MoWaleid/Convlution_Accelerator/Important documents/Architecture_Mapping.html

# Architecture Decision Mapping

This document maps the complete list of 17 recommended architecture decisions from the CNN_Accelerator_Spec_Decisions.pdf specification to the current VHDL implementation in the project.

## Decision Matrix

# | Decision Area | Recommended Choice (Spec) | Implemented Choice (Project) | Status | Rationale / Location

1 | Input pixel format | 8-bit unsigned integer (Q8.0) | 8-bit unsigned integer | Matched | Implemented in config_pkg.vhd (CFG_PIXEL_WIDTH = 8). Matches golden model.
2 | Kernel format | Raw signed 8-bit integer | Raw signed 8-bit integer | Matched | Implemented in config_pkg.vhd (CFG_WEIGHT_WIDTH = 8). Matches golden model.
3 | Accumulator width | Worst-case formula (21 bits for N=3) | 24 bits | Matched | Implemented in config_pkg.vhd (CFG_ACCUM_WIDTH = 24). Rounded up for cleaner DSP/fabric boundaries.
4 | Rescale shift | Programmable per-channel | Programmable per-channel | Matched | Implemented via AXI control in coeff_bias_shift_regfile.vhd (Word 33 per channel).
5 | Rounding | Round-half-up | TBD (Golden Model Matched) | Pending RTL | Currently verified in golden model (golden_conv.py), but the RTL datapath array (MAC units) is not yet built.
6 | Overflow handling | Saturate | TBD (Golden Model Matched) | Pending RTL | Currently verified in golden model (golden_conv.py), but the RTL datapath array (MAC units) is not yet built.
7 | Boundary convention | "Valid" convolution (no padding) | "Valid" convolution | Matched | Implemented in window_generator.vhd. valid_out only asserts after N-1 rows/cols. Golden model manually pre-pads to verify.
8 | Kernel-size (N) | Compile-time VHDL generic, default N=3 | Compile-time generic, N=3 | Matched | Implemented in config_pkg.vhd (CFG_N = 3).
9 | Multi-kernel parallelism | K shared-window channels, target K=4 | K=16 channels | Exceeded | Implemented in config_pkg.vhd (CFG_K = 16). Provides 4x higher parallelism than the baseline target.
10 | Compute topology | Direct parallel MAC array | TBD | Pending RTL | RTL datapath array not yet built.
11 | Multiplier implementation | LUT-fabric (use_dsp=no) | TBD | Pending RTL | RTL datapath array not yet built.
12 | Line-buffer memory | SRL-based fabric shift registers (zero BRAM) | SRL-based arrays | Matched | Implemented in window_generator.vhd using 1D arrays of std_logic_vector to infer SRL32s.
13 | Pipelining | 3-5 structural stages + Vivado retiming | TBD | Pending RTL | RTL datapath array not yet built.
14 | ReLU | Per-channel runtime-toggleable | Per-channel runtime-toggleable | Matched | Implemented via AXI control in coeff_bias_shift_regfile.vhd (Bit 8 of Word 33 per channel).
15 | Control interface | AXI4-Lite register map | AXI4-Lite | Matched | Implemented in axi_lite_ctrl.vhd mapping to the register file.
16 | Data interface | AXI4-Stream + AXI DMA (PS DDR ↔ PL) | TBD | Pending RTL | Top-level block and AXI-Stream interfaces have not been assembled yet.
17 | PS software stack | PetaLinux + native on-target Python | TBD | Pending Software | The hardware-software integration phase has not been started yet.

## Summary

The current RTL implementation closely follows the recommendations outlined in the specification document for all of the modules built so far. Notably, the hardware achieves zero BRAM usage for line buffers by correctly utilizing SRL primitives. It also incorporates all mandatory runtime programmability requirements (per-channel rescale shifts and ReLU enables) over a standard AXI4-Lite interface. Furthermore, the design pushes performance beyond the baseline target by implementing 16 parallel output channels (K=16) instead of the requested 4.

Note: The core MAC array (Compute Topology, Multipliers, Pipelining, Rounding, Overflow Handling), Top-Level Data Interfaces (AXI-Stream), and PS Software Stack are currently marked as pending as they have not yet been implemented in the source files. The Golden Model scripts already implement the correct Rounding and Saturation logic pending RTL integration.
