MoWaleid/Convlution_Accelerator/report/figures/fig7_utilization.png

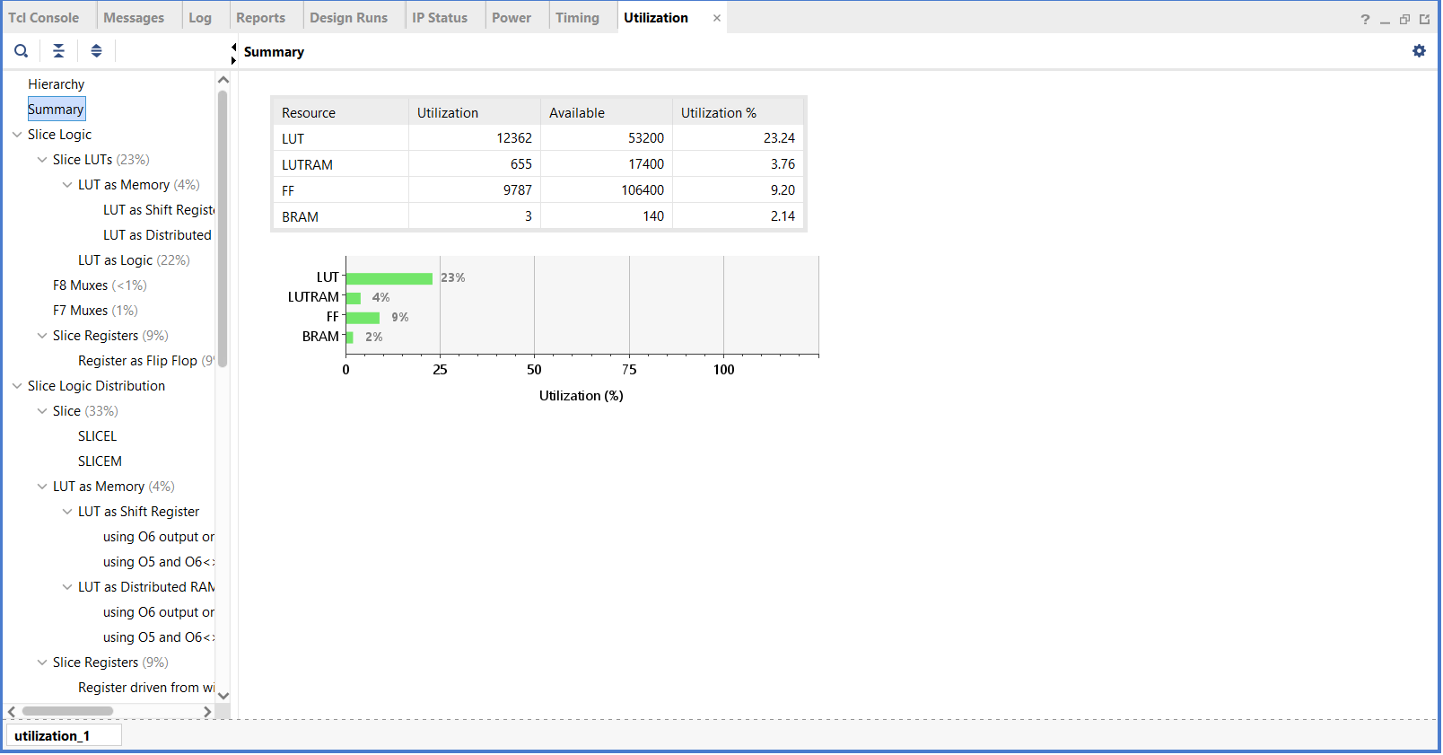
report/figures/fig7_utilization.png
