MoWaleid/Convlution_Accelerator/report/figures/fig8_timing_summary.png

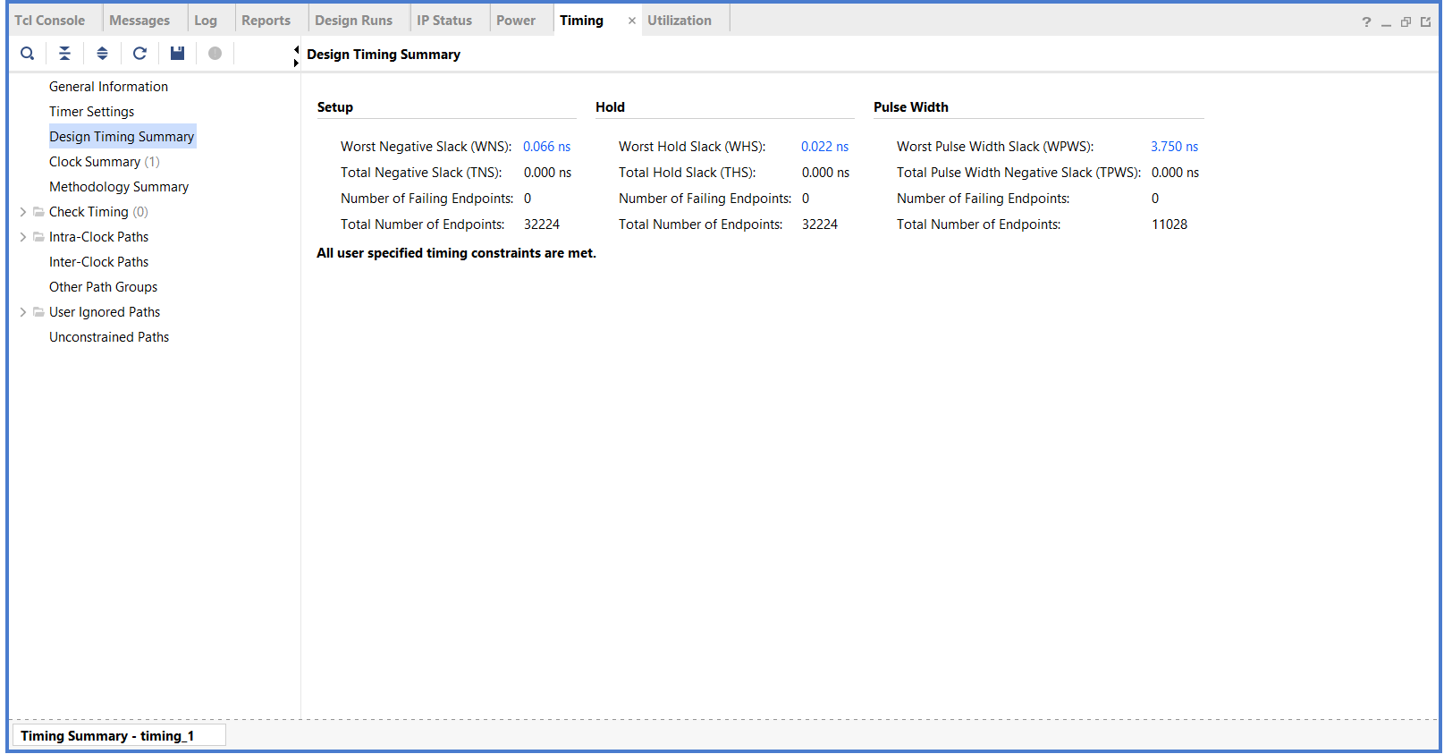
report/figures/fig8_timing_summary.png
