MoWaleid/Convlution_Accelerator/deploy/petalinux/recipes-apps/conv-lab-validation/files/INSTALLED_SHA256SUMS.txt

ea9cca2efb4a6f9e74c8f9849b9e1d61bbfc4c97b9649718dbb82cb657fc61f1  /opt/conv-lab/app/conv_lab/__init__.py
0ccd1de3e55b3437ee6acf62e0fa21a69f0a7768752000d04625c2480c98fd29  /opt/conv-lab/app/conv_lab/_decoder_worker.py
7d66fa962028779ab764f58c7f8f79614e87b4f32e368aeddb5187a3a1e163a5  /opt/conv-lab/app/conv_lab/admission.py
b2878de9ea6ba7eecb173c680f9a57cc86487c63c51e9f7723fe9634d21ecaa7  /opt/conv-lab/app/conv_lab/bundles.py
992064e55daa3645f3b8337a1cb6f19396265100392b3cc030cf270d5da5d981  /opt/conv-lab/app/conv_lab/convert_legacy.py
26fe9c3177d2a8651487007d6498370f98942abf5b35c8494a605ac6e15d09a9  /opt/conv-lab/app/conv_lab/dma.py
7afdc2dead21b8273672f3de1dd12226209d65b82ccc8693de7ca26805de04c5  /opt/conv-lab/app/conv_lab/errors.py
73b7eba7304ad4c4b50bce89c4152326523df2a3f7790c08b00de94c888f8b11  /opt/conv-lab/app/conv_lab/legacy.py
b40445999fc7e04be0155ae02ecb6b5809e3e08e5c1e81720246cf3e39aa152f  /opt/conv-lab/app/conv_lab/offline.py
c749fd176e401258018ea5ea97697aa9c52eed748435e0daa05fc4213cc9891e  /opt/conv-lab/app/conv_lab/preprocessing.py
5172c6d424bf7aa90a54846889cb2cec460f3103ce2590d96baac65529c433b6  /opt/conv-lab/app/conv_lab/reference.py
957431e5d61774b103c58749986a42b1845c5fe769215b402d80a4c9a57ceacb  /opt/conv-lab/app/conv_lab/release_io.py
b4636e79ecac3af7c026b600c922b88e42f8ad961f2bf09d54d50d0886fdfb4a  /opt/conv-lab/app/conv_lab/schemas.py
11f0179c3eb9cf5c3550df679c88ec458b3b3c65424d7ce08f84249e9b40b35e  /opt/conv-lab/app/conv_lab/storage.py
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
31ff39dc84828e4fa7e72bd1b80c5df45dcf4306496224f2f61cc4b8c449ac43  /opt/conv-lab/validation/evidence/trained_cifar_vector_audit.json
86ce223687c98172ad5373c92d0769511cdd74217537005fe965fecae31337bb  /usr/bin/conv-lab-offline
edb60cf0b1d1d7fb573ff32e75457183acfbf16c7d70dd74741c73bda96941d7  /usr/bin/conv-lab-tests
2df9cb271536a6e89c38f94c4c132c7f7f1e92b46783822e8adbfab15a9573c2  /usr/sbin/conv-lab-prepare-output
