MoWaleid/Convlution_Accelerator/report/research_builds/B32_CFGLUT125/rebuild_20260915/results.txt

release_id=B32_CFGLUT125
shape_id=N3K16W32H32-CVH1
MHz=125
WNS=0.090
WHS=0.053
BOARD_VALIDATION=NOT_RUN
