MoWaleid/Convlution_Accelerator/report/research_builds/CFGLUT125_MATRIX/wrapper_official_user_20260914T210835Z/A32_CFGLUT125__optimized/run_result.txt

PROFILE_WRAPPER_IDENTITY_OK: A32_CFGLUT125 K=8 N=3 W=32 H=32 build_id=45463132354b30384e33573332523031
PROFILE_WRAPPER_PASS: A32_CFGLUT125 optimized
OPTION_A_EXTERNAL_GAPLESS_CLAIM=yes
