MoWaleid/Convlution_Accelerator/report/research_builds/CFGLUT125_MATRIX/wrapper_official_user_20260914T210835Z/C32_CFGLUT125__optimized_relaxed/run_result.txt

PROFILE_WRAPPER_IDENTITY_OK: C32_CFGLUT125 K=8 N=5 W=32 H=32 build_id=45463132354b30384e35573332523031
PROFILE_WRAPPER_PASS: C32_CFGLUT125 optimized_relaxed
OPTION_A_EXTERNAL_GAPLESS_CLAIM=no
