MoWaleid/Convlution_Accelerator/report/research_builds/CFGLUT125_MATRIX/wrapper_official_user_20260914T210835Z/D640_CFGLUT125__optimized_relaxed/run_result.txt

PROFILE_WRAPPER_IDENTITY_OK: D640_CFGLUT125 K=4 N=3 W=640 H=480 build_id=45463132354e334b30345647412d5231
PROFILE_WRAPPER_PASS: D640_CFGLUT125 optimized_relaxed
OPTION_A_EXTERNAL_GAPLESS_CLAIM=no
