MoWaleid/Convlution_Accelerator/report/research_builds/D32_CFGLUT125/results.txt

release_id=D32_CFGLUT125
shape_id=N3K4W32H32-CVH1
MHz=125
WNS=0.093
WHS=0.014
BOARD_VALIDATION=NOT_RUN
