MoWaleid/Convlution_Accelerator/report/research_builds/A32_CFGLUT125/results.txt

release_id=A32_CFGLUT125
shape_id=N3K8W32H32-CVH1
MHz=125
WNS=0.197
WHS=0.037
BOARD_VALIDATION=NOT_RUN
