MoWaleid/Convlution_Accelerator/report/research_builds/D640_CFGLUT125/results.txt

release_id=D640_CFGLUT125
shape_id=N3K4W640H480-CVH1
MHz=125
WNS=0.001
WHS=0.022
BOARD_VALIDATION=NOT_RUN
