MoWaleid/Convlution_Accelerator/report/research_builds/C32_CFGLUT125/results.txt

release_id=C32_CFGLUT125
shape_id=N5K8W32H32-CVH1
MHz=125
WNS=0.003
WHS=0.037
BOARD_VALIDATION=NOT_RUN
