MoWaleid/Convlution_Accelerator/report/research_builds/B32_CFGLUT100/results.txt

release_id=B32_CFGLUT100
shape_id=N3K16W32H32-CVH1
MHz=100
WNS=0.764
WHS=0.011
BOARD_VALIDATION=NOT_RUN
