MoWaleid/Convlution_Accelerator/Convlution_Accelerator.srcs/sources_1/new/conv_axis_wrapper_bd.v

// Vivado IP Integrator module-reference adapter for the VHDL-2008 wrapper.
// The adapter adds standard AXI interface metadata and normalizes physical
// addresses to local 64 KiB offsets for conv_axis_wrapper.vhd.
`timescale 1 ns / 1 ps

module conv_axis_wrapper_bd (
    (* X_INTERFACE_INFO = "xilinx.com:signal:clock:1.0 clk CLK" *)
    // FREQ_HZ is intentionally omitted.  The connected PS FCLK is the single
    // clock authority, allowing the same RTL to be built as a checked 100 MHz
    // or 125 MHz release without stale module-reference metadata.
    (* X_INTERFACE_PARAMETER = "XIL_INTERFACENAME clk, ASSOCIATED_BUSIF S_AXI:S_AXIS:M_AXIS, ASSOCIATED_RESET resetn" *)
    input wire clk,
    (* X_INTERFACE_INFO = "xilinx.com:signal:reset:1.0 resetn RST" *)
    (* X_INTERFACE_PARAMETER = "XIL_INTERFACENAME resetn, POLARITY ACTIVE_LOW" *)
    input wire resetn,

    // The BD address map constrains this slave to an aligned 64 KiB aperture covering
    // the frozen local offsets through 0x400C. Keep the native 32-bit AXI
    // address ports so Vivado's AXI interface metadata matches the core.
    (* X_INTERFACE_INFO = "xilinx.com:interface:aximm:1.0 S_AXI AWADDR" *) input wire [31:0] S_AXI_AWADDR,
    (* X_INTERFACE_INFO = "xilinx.com:interface:aximm:1.0 S_AXI AWPROT" *) input wire [2:0] S_AXI_AWPROT,
    (* X_INTERFACE_INFO = "xilinx.com:interface:aximm:1.0 S_AXI AWVALID" *) input wire S_AXI_AWVALID,
    (* X_INTERFACE_INFO = "xilinx.com:interface:aximm:1.0 S_AXI AWREADY" *) output wire S_AXI_AWREADY,
    (* X_INTERFACE_INFO = "xilinx.com:interface:aximm:1.0 S_AXI WDATA" *) input wire [31:0] S_AXI_WDATA,
    (* X_INTERFACE_INFO = "xilinx.com:interface:aximm:1.0 S_AXI WSTRB" *) input wire [3:0] S_AXI_WSTRB,
    (* X_INTERFACE_INFO = "xilinx.com:interface:aximm:1.0 S_AXI WVALID" *) input wire S_AXI_WVALID,
    (* X_INTERFACE_INFO = "xilinx.com:interface:aximm:1.0 S_AXI WREADY" *) output wire S_AXI_WREADY,
    (* X_INTERFACE_INFO = "xilinx.com:interface:aximm:1.0 S_AXI BRESP" *) output wire [1:0] S_AXI_BRESP,
    (* X_INTERFACE_INFO = "xilinx.com:interface:aximm:1.0 S_AXI BVALID" *) output wire S_AXI_BVALID,
    (* X_INTERFACE_INFO = "xilinx.com:interface:aximm:1.0 S_AXI BREADY" *) input wire S_AXI_BREADY,
    (* X_INTERFACE_INFO = "xilinx.com:interface:aximm:1.0 S_AXI ARADDR" *) input wire [31:0] S_AXI_ARADDR,
    (* X_INTERFACE_INFO = "xilinx.com:interface:aximm:1.0 S_AXI ARPROT" *) input wire [2:0] S_AXI_ARPROT,
    (* X_INTERFACE_INFO = "xilinx.com:interface:aximm:1.0 S_AXI ARVALID" *) input wire S_AXI_ARVALID,
    (* X_INTERFACE_INFO = "xilinx.com:interface:aximm:1.0 S_AXI ARREADY" *) output wire S_AXI_ARREADY,
    (* X_INTERFACE_INFO = "xilinx.com:interface:aximm:1.0 S_AXI RDATA" *) output wire [31:0] S_AXI_RDATA,
    (* X_INTERFACE_INFO = "xilinx.com:interface:aximm:1.0 S_AXI RRESP" *) output wire [1:0] S_AXI_RRESP,
    (* X_INTERFACE_INFO = "xilinx.com:interface:aximm:1.0 S_AXI RVALID" *) output wire S_AXI_RVALID,
    (* X_INTERFACE_INFO = "xilinx.com:interface:aximm:1.0 S_AXI RREADY" *) input wire S_AXI_RREADY,

    (* X_INTERFACE_INFO = "xilinx.com:interface:axis:1.0 S_AXIS TDATA" *) input wire [63:0] s_axis_tdata,
    (* X_INTERFACE_INFO = "xilinx.com:interface:axis:1.0 S_AXIS TKEEP" *) input wire [7:0] s_axis_tkeep,
    (* X_INTERFACE_INFO = "xilinx.com:interface:axis:1.0 S_AXIS TVALID" *) input wire s_axis_tvalid,
    (* X_INTERFACE_INFO = "xilinx.com:interface:axis:1.0 S_AXIS TREADY" *) output wire s_axis_tready,
    (* X_INTERFACE_INFO = "xilinx.com:interface:axis:1.0 S_AXIS TLAST" *) input wire s_axis_tlast,

    (* X_INTERFACE_INFO = "xilinx.com:interface:axis:1.0 M_AXIS TDATA" *) output wire [63:0] m_axis_tdata,
    (* X_INTERFACE_INFO = "xilinx.com:interface:axis:1.0 M_AXIS TKEEP" *) output wire [7:0] m_axis_tkeep,
    (* X_INTERFACE_INFO = "xilinx.com:interface:axis:1.0 M_AXIS TVALID" *) output wire m_axis_tvalid,
    (* X_INTERFACE_INFO = "xilinx.com:interface:axis:1.0 M_AXIS TREADY" *) input wire m_axis_tready,
    (* X_INTERFACE_INFO = "xilinx.com:interface:axis:1.0 M_AXIS TLAST" *) output wire m_axis_tlast
);

    conv_axis_wrapper accelerator_i (
        .clk(clk),
        .resetn(resetn),
        .S_AXI_AWADDR({16'h0000, S_AXI_AWADDR[15:0]}),
        .S_AXI_AWPROT(S_AXI_AWPROT),
        .S_AXI_AWVALID(S_AXI_AWVALID),
        .S_AXI_AWREADY(S_AXI_AWREADY),
        .S_AXI_WDATA(S_AXI_WDATA),
        .S_AXI_WSTRB(S_AXI_WSTRB),
        .S_AXI_WVALID(S_AXI_WVALID),
        .S_AXI_WREADY(S_AXI_WREADY),
        .S_AXI_BRESP(S_AXI_BRESP),
        .S_AXI_BVALID(S_AXI_BVALID),
        .S_AXI_BREADY(S_AXI_BREADY),
        .S_AXI_ARADDR({16'h0000, S_AXI_ARADDR[15:0]}),
        .S_AXI_ARPROT(S_AXI_ARPROT),
        .S_AXI_ARVALID(S_AXI_ARVALID),
        .S_AXI_ARREADY(S_AXI_ARREADY),
        .S_AXI_RDATA(S_AXI_RDATA),
        .S_AXI_RRESP(S_AXI_RRESP),
        .S_AXI_RVALID(S_AXI_RVALID),
        .S_AXI_RREADY(S_AXI_RREADY),
        .s_axis_tdata(s_axis_tdata),
        .s_axis_tkeep(s_axis_tkeep),
        .s_axis_tvalid(s_axis_tvalid),
        .s_axis_tready(s_axis_tready),
        .s_axis_tlast(s_axis_tlast),
        .m_axis_tdata(m_axis_tdata),
        .m_axis_tkeep(m_axis_tkeep),
        .m_axis_tvalid(m_axis_tvalid),
        .m_axis_tready(m_axis_tready),
        .m_axis_tlast(m_axis_tlast)
    );

endmodule
