MoWaleid/Convlution_Accelerator/Convlution_Accelerator.srcs/sim_1/new/tb_conv_channel_shifts.vhd

-- ============================================================================
-- tb_conv_channel_shifts.vhd -- research-line numerical gauntlet
-- ============================================================================
-- Proves the CFGLUT5/Dadda channel against an independent 64-bit reference
-- across every encoded shift, signed-24 bias endpoints, exact half-rounding
-- boundaries, positive/negative nonzero products, saturation, and ReLU.
-- One item is kept in flight at a time so runtime parameters remain constant
-- for the complete arithmetic pipeline, matching the frame-level ABI.
-- ============================================================================

library IEEE;
use IEEE.STD_LOGIC_1164.ALL;
use IEEE.NUMERIC_STD.ALL;

library STD;
use STD.ENV.ALL;

library work;
use work.config_pkg.all;
use work.conv_pkg.all;

entity tb_conv_channel_shifts is
end entity tb_conv_channel_shifts;

architecture sim of tb_conv_channel_shifts is
    constant C_N          : positive := 3;
    constant C_K          : positive := 1;
    constant C_TAPS       : positive := C_N * C_N;
    constant C_WEIGHT_SETS : positive := 5;
    constant C_BIAS_CASES : positive := 8;
    constant CLK_PERIOD   : time := 8 ns;

    signal clk    : std_logic := '0';
    signal resetn : std_logic := '0';

    signal window_in : pixel_array_t(0 to C_TAPS - 1) :=
        (others => (others => '0'));
    signal valid_in : std_logic := '0';

    signal biases : bias_array_t(0 to C_K - 1) :=
        (others => (others => '0'));
    signal shifts : shift_array_t(0 to C_K - 1) :=
        (others => (others => '0'));
    signal relus : std_logic_vector(0 to C_K - 1) := (others => '0');

    signal coeff_write_pulse : std_logic := '0';
    signal coeff_write_addr  : std_logic_vector(31 downto 0) :=
        (others => '0');
    signal coeff_write_data  : std_logic_vector(31 downto 0) :=
        (others => '0');
    signal cfg_ready   : std_logic;
    signal results_out : output_array_t(0 to C_K - 1);
    signal valid_out   : std_logic;

    function weight_for(
        set_index : natural;
        tap       : natural
    ) return integer is
    begin
        case set_index is
            when 0 =>
                return 0;
            when 1 =>
                return 127;
            when 2 =>
                return -128;
            when 3 =>
                case tap is
                    when 0 => return -128;
                    when 1 => return -127;
                    when 2 => return -1;
                    when 3 => return 0;
                    when 4 => return 1;
                    when 5 => return 2;
                    when 6 => return 63;
                    when 7 => return 126;
                    when others => return 127;
                end case;
            when others =>
                case tap is
                    when 0 => return 127;
                    when 1 => return -128;
                    when 2 => return 85;
                    when 3 => return -86;
                    when 4 => return 64;
                    when 5 => return -65;
                    when 6 => return 3;
                    when 7 => return -2;
                    when others => return -1;
                end case;
        end case;
    end function weight_for;

    function packed_word(
        set_index  : natural;
        word_index : natural
    ) return std_logic_vector is
        variable value : std_logic_vector(31 downto 0) := (others => '0');
        variable tap   : natural;
    begin
        for lane in 0 to 3 loop
            tap := word_index * 4 + lane;
            if tap < C_TAPS then
                value(8 * lane + 7 downto 8 * lane) :=
                    std_logic_vector(to_signed(weight_for(set_index, tap), 8));
            end if;
        end loop;
        return value;
    end function packed_word;
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
