MoWaleid/Convlution_Accelerator/(commit log)

2026-09-01 fix: harden AXI4-Lite slave protocol
    [axi_lite_ctrl.vhd, coeff_bias_shift_regfile.vhd, tb_axi_lite_ctrl.vhd, tb_coeff_bias_shift_regfile.vhd]
2026-09-01 feat: add lossless datapath stall support
    [conv_channel.vhd, conv_engine.vhd, conv_top.vhd, tb_conv_datapath_stall.vhd, tb_conv_top.vhd, tb_window_generator.vhd, window_generator.vhd]
2026-09-01 fix: remove AXI input inter-beat bubble
    [axi_stream_input_frontend.vhd, tb_axi_stream_input_frontend.vhd]
2026-09-01 fix: support independent image height
    [axi_stream_output_serializer.vhd, config_pkg.vhd, conv_top.vhd, tb_axi_stream_output_serializer.vhd, tb_conv_datapath_stall.vhd, tb_window_generator.vhd, tb_window_generator_nonsquare.vhd, window_generator.vhd]
2026-09-01 feat: add accelerator soft reset
    [axi_lite_ctrl.vhd, conv_axis_wrapper.vhd, conv_top.vhd, tb_axi_lite_ctrl.vhd, tb_conv_axis_wrapper.vhd, tb_conv_top.vhd]
2026-09-01 feat: integrate accelerator and AXI DMA block design
2026-09-01 fix: make AXI input lane scans synthesis-safe
    [axi_stream_input_frontend.vhd]
2026-09-01 fix: make AXI output packing synthesis-safe
    [axi_stream_output_serializer.vhd]
2026-09-11 finalized M3 officially
    [gp0_accel_addrfix_2026-09-05_01.csv, gp0_accel_config_zero_2026-09-05_01.csv, gp0_dma_hang_2026-09-05_01.csv, gp0_dma_hang_2026-09-05_02.csv, gp0_dma_len16_bias_smoke_2026-09-06_01.csv, gp0_dma_len16_nonzero3x3_2026-09-06_01.csv, gp0_dma_len16_repeat20_2026-09-06_01.csv, gp0_dma_len16_trained_cifar_k8_2026-09-06_01.csv]
2026-09-12 M7: qualify five profiles and runtime model switching
    Switch manager repaired per 8-P1 review, board-proven end-to-end (md5 e853933b...). Evidence 2026-09-13: A32-B32 first switch PASS; A32/C32/D32/D640 singles PASS; full matrix PASS (58 switches, 58 full-PL reloads, 20/20 ordered pairs, 404.4 s); 100-frame soaks x5 PASS (D640 median 3.731 ms timed, anchor-SHA validation); same-build parameter-only path proven; cold-boot fallback PASS. Session: 577 frames, 0 mismatches; program: 765+ frames, 90 verified full-PL reconfigurations. Transcripts in report/evidence/m7_*.txt; AI_HANDOFF and M7_STATE updated.
2026-09-13 M8: Phase A CLI + run archive; reconcile board source; fix review P1s
    E1: board reconciled to committed m7_switch (184d75c0), smoke-verified A32/D640; evidence transcripts annotated. Manager: flock exclusive ownership, approved four-guard layout (runtime allocation, 22-bit bounds, physical alignment, D640 manifest rx 313728), legal-RESET cleanup with PASS gated on final 0x181 in all modes. m8_cli Phase A: run/benchmark/list/record over the exclusive-owner backend, run archive at /var/lib/conv-lab/results, display-only previews, measurement harness; UNVERIFIED outcome for sha-only runs; atomic records; exclusive run-dir allocation; record-command containment; storage admission (256 MiB budget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
    [mock_switch_test.py]
2026-09-13 report: apply correction queue + M7/M8 evidence; file M8 board validation record
    Throughput 4/K relabeled as output-interface ceiling (theoretical bound) in S3/S9.1/S11/S12; removed the 1,024-cycle/10.24us datapath claim; measured wall-clock scopes kept explicit. S5 buffer layout updated to the approved four-guard per-profile formula. New S10.1 multi-profile section: five compiled profiles with BUILD_IDs, qualified WNS, models, 58-switch matrix (20/20 pairs), 5x100-frame soaks, cold-boot fallback, 90 total full-PL reconfigurations. Frame totals reconciled to 876 across 20+ runs. Sources S16-S20 added; D640 final post-physopt timing reports frozen under report/profile_builds/D640/final/. M8 C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
2026-09-13 M8 Phase B: validated bundle importer (m8_import.py) + 15-case test suite
    Model/dataset bundle import from a transport archive: bounded traversal-safe extraction (member/size caps, tarfile data filter), strict validation via conv_lab.strict (schema/identity/compatibility/ABI, format-3 channel config with signed-24 bias bounds, reduced rational scales, coefficient grammar over hashed bytes), FileRef hash verification, identity-collision rejection with idempotent same-content re-import, atomic publication to /var/lib/conv-lab/library, receipts outside bundle contents, storage headroom admission, flock serialization. 15/15 host tests PASS. Hardware-bundle import explicitly unsupported in this r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
2026-09-13 M8: file importer board evidence; update handoff with Phase B status and push lessons
2026-09-13 M7-R4: strict canonical bundle admission, catalog/manifest cross-validation, width registers
    scripts/convert_legacy_profiles.py: explicit legacy-flat-2 -> canonical-flat-2 conversion of all five parameter bundles (boolean relu_en, explicit weights_file, declared signed-24 bias width replacing the stale bias_bits=32 declaration, kernel .mem bytes untouched) with recorded source/output hashes in profiles/history/legacy_conversion_20260914.json. m7_switch load_params now admits only the canonical dialect via conv_lab.strict (exact field sets, canonical types, coefficient grammar over hashed bytes, no silent ReLU coercion) and returns an immutable whole-bundle SHA-256 logged at admission. switch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
2026-09-13 handoff: M7-R4 closed (board-proven); remaining M8-02, M8-07 remainder, E2
2026-09-13 M8-02: route --image decoding through the M2 isolated bounded decoder worker
    conv_lab.preprocessing: scoped extension adding root-supervisor demotion (LinuxDecoder(demote_to=(uid,gid))) so the sudo hardware backend can spawn the unprivileged RLIMIT-AS worker; the worker keeps its own privilege refusals, address-space ceiling, 30 s deadline, bounded IPC, and zero inherited descriptors (close_fds/pass_fds=()). m8_cli load_image_exact now delegates entirely to the worker - canonical bytes plus the validated preprocessing record (decode_policy.resource_strategy) flow into the run record; no in-process decode fallback exists. Mock suite updated with a fixture loader for non-Linux hosts; suite PAS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
2026-09-13 M8-02: file worker-isolation board evidence; handoff updated
2026-09-13 E2: per-profile extremes mode + provably-consecutive matrix cycles + mock fidelity fix
    m7_switch build_matrix_sequence: bridge to A32 before the counted block, making the 20 A32-B32-A32 cycles provably consecutive regardless of live start profile (review E2). m8_cli cmd_extremes: per-profile M5-grade stimuli - all-zero and all-255 frames under admitted parameters, a temporary saturation-parameter stimulus (weights full-scale, biases at both signed-24 endpoints, shift 0) requiring both output rails (32767/-32768) to be exercised, then explicit canonical-bundle reinstallation with anchor-checked activation per M1_ACTIVATION_LIFECYCLE; every frame verified against the exact reference with zero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
    [mock_switch_test.py]
2026-09-13 M8 COMPLETE: E2 closed — per-profile extremes x5 + provably-consecutive matrix rerun (board-proven)
    Board evidence (report/evidence/e2_extremes_matrix_20260914.txt): m8_cli extremes for all five profiles - 20 stimulus frames, each verified value-by-value against the exact reference; saturation stimulus requires both +32767 and -32768 rails with biases at both signed-24 endpoints and shift 0; canonical reinstall + anchor revalidation per lifecycle. Matrix rerun with the A32-bridge construction: 58 switches, 58 full-PL reloads, 20 provably consecutive A32-B32-A32 cycles, 20/20 ordered pairs, 57.5 s, all activations anchor-exact. AI_HANDOFF: M8 row PASS, E2 closed, 16.7 consumed. Remaining: M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
2026-09-13 fix: m8_cli soak progress print (log -> print; caught at frame 25 on board, mock soaks were under the progress threshold)
2026-09-13 M9 §2 complete: 1,000-frame varied soak — 6/6 legs PASS, zero mismatches (evidence filed)
2026-09-13 M9 §3 complete: five true power-cycle cold boots — 5/5 PASS across four reload paths + parameter-only path (evidence filed)
2026-09-13 integration plan: Addendum A — Codex review dispositions (IP/FP/R14 verified first-hand, corrected execution order)
2026-09-13 handoff: §17 context-reset-safe current state (review dispositions, action queue, lessons); supersedes stale sections
2026-09-13 handoff: current-state pointer at top (routes fresh contexts to §17)
2026-09-13 R14-02..05 repair batch + R14-01 containment (option b, shift>=24 rejected); mock negatives 8->17 cases all PASS; fix C_FULL_W stale comment
    [conv_channel.vhd]
2026-09-14 recovery: qualified A32 firmware + runtime manifest + schema-v3 board records (FP-02 closed); board revalidation of R14 repairs PASS
2026-09-14 docs: truth pass — report totals to 1,966 frames/148 reloads with M9+E2 sources S21-S24; profiles/software READMEs reconciled to qualified reality; M9 checklist intro fixed
2026-09-14 M10 Gate 1: decision record draft — D1 ZedBoard, D2 orthogonal identities (release/shape/bundle), D3 research build flow, D4 status
2026-09-14 M10 Gate 1 D2: orthogonal release identities — catalog v2 releases section (content-bound bundles), switch_to enforcement (build_id/shape/bundle sha), run records carry release_id/shape_id; mocks 17-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
2026-09-14 M10 Gate 1: bitheap provenance verified (generator regenerates committed cfglut5_bitheap_3x3.vhd byte-identically); D4 xsim counterexample testbench staged
2026-09-14 M10 Gate 1 D4 closed: R14-01 confirmed by xsim on baseline (shifts 25/26/31 -> -1 vs reference 0; case 0 sanity OK) — record + release manifest updated
2026-09-14 M10 Gate 1 D3+D5: research release flow stood up (scripts/research_release: fresh-project Tcl + catalog-crosschecking driver + B32_CFGLUT125 spec, fail-closed pre-transplant); WNS discrepancy resolve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
2026-09-14 handoff: M10 resumption brief for next AI session (Gate 1 complete, Gate 2 transplant staged uncommitted in tree, remaining order + gotchas)
2026-09-14 Gate 2: B32_CFGLUT125 release plumbing — catalog/anchor/manifest entries, m7_switch bundle_dir + FW_NAME, research_release check fix (completes the transplant commit)
2026-09-14 Gate 3: record 125 MHz board boot identity
2026-09-14 Gate 3: preserve CFGLUT125 board run records
2026-09-14 Stage the five-release CFGLUT125 matrix and generalize the wrapper TB
    - Four new release specs A32/C32/D32/D640_CFGLUT125 (125 MHz, final BUILD_IDs,
    both generated bitheaps in sources); research_release check PASS x5
    - Catalog profiles+releases entries, four fail-closed manifests
    (TBD_FIRST_BUILD hashes), anchors transferred with provenance, FW_NAME map
    - tb_conv_axis_wrapper (A-H) generalized to N in {3,5} x K in {4,8,16} from
    config_pkg geometry: NxN reference, coefficient packing, exact-multiple
    final beat, geometry-scaled ABORT beat count and timeout; K16/N3 semantics
    unchanged
    - test_profile_wrappers.tcl: per-release A-H runner with rendered config_pkg
    and N-aware metric exp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
    [tb_conv_axis_wrapper.vhd]
2026-09-14 Fix duplicated final input beat in generalized wrapper TB
    The frame-sender generalization added the conditional trailing partial beat
    inside the new if-block but left the original unconditional trailing
    send_input_beat after the pixel-count assert. At K16/N3 the frame therefore
    carried a second TLAST beat: the DUT correctly completed the frame at 1156
    bytes and gated further input, and the TB spun forever on the rejected beat
    (wait_for_success never entered). The bug is geometry-independent (all five
    profiles affected); the first partial TLAST beat was correct, so the DUT-side
    frame data in the failed runs was complete and exact.
    Fix verified: full A-H B32_CFGLUT125 regression passes with m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
    [tb_conv_axis_wrapper.vhd]
2026-09-14 Close wrapper-sim campaign: claim scope per user decision, D640 fixture fix, evidence
    - TB input_pixel_value truncates r+c to 8 bits so the reference matches the
    byte stream at 640-wide profiles (D640 position-252 mismatch was a fixture
    bug; the DUT was bit-exact)
    - Runner: optimized_relaxed variant (G_REQUIRE_CONTINUOUS=false) with
    geometry-aware checker; gapless assertions gated to N=3/K>=8
    - debug_wrapper_sim.tcl: per-release output directories
    - Evidence: report/research_builds/CFGLUT125_MATRIX/profile_wrapper_sims_20260914.md
    records all five A-H results (B32/A32 strict gapless PASS; C32 62/31,
    D32 62/62, D640 958/958 relaxed PASS) and the user's option-a decision
    - AI_HANDOFF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
    [tb_conv_axis_wrapper.vhd]
2026-09-15 Cut active catalog to the five CFGLUT125 releases
2026-09-15 Prepare G5 runtime staging archive for board install
2026-09-15 Record G5 runtime staging complete on board
2026-09-15 Open G5 board qualification transcript (A32 PASS)
2026-09-15 G5 qualification: four 32x32 100-frame soaks PASS
2026-09-15 Record G5 per-release board gates closed (18.21)
2026-09-15 G5 qualification: five-profile switching matrix PASS (58/58)
