MoWaleid/Convlution_Accelerator/(notices)

Notices in the files:
profile_builds/B32_20260912_152252_16764_1816486359028/project/M7_B32.srcs/constrs_1/imports/Convlution_Accelerator/Zedboard-Master.xdc:
Copyright(c) 2012 Avnet, Inc.
All rights reserved.
